Bankbuster777/Akwek/window_handle/images/back_socket.png

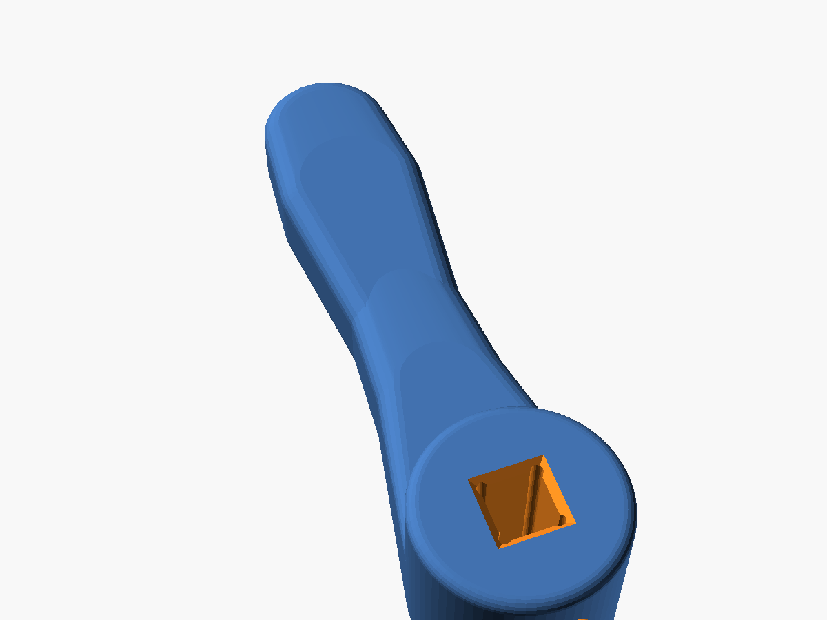
window_handle/images/back_socket.png
