Bankbuster777/Akwek/window_handle/images/screw_detail.png

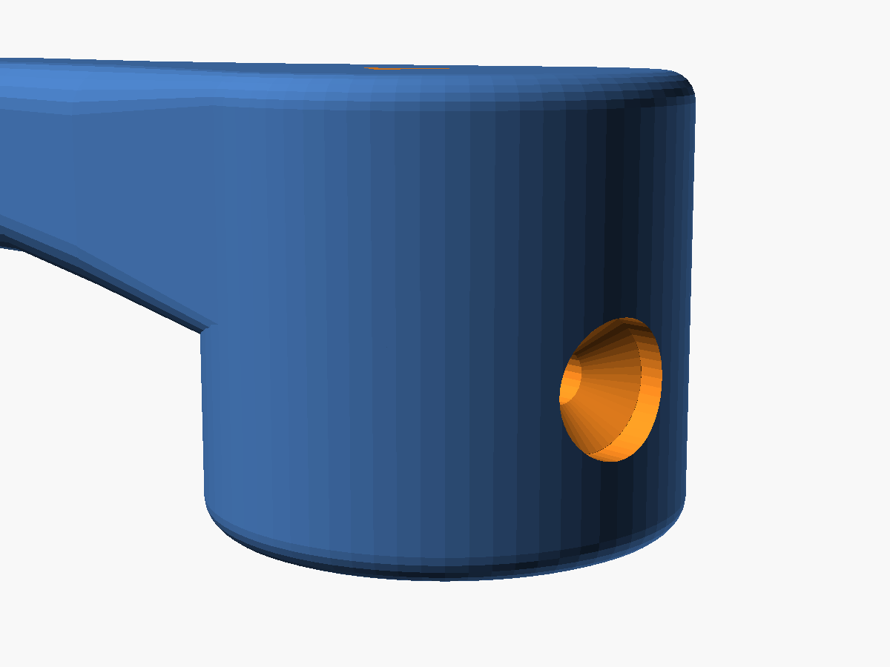
window_handle/images/screw_detail.png
