Bankbuster777/Akwek/window_handle/images/section.png

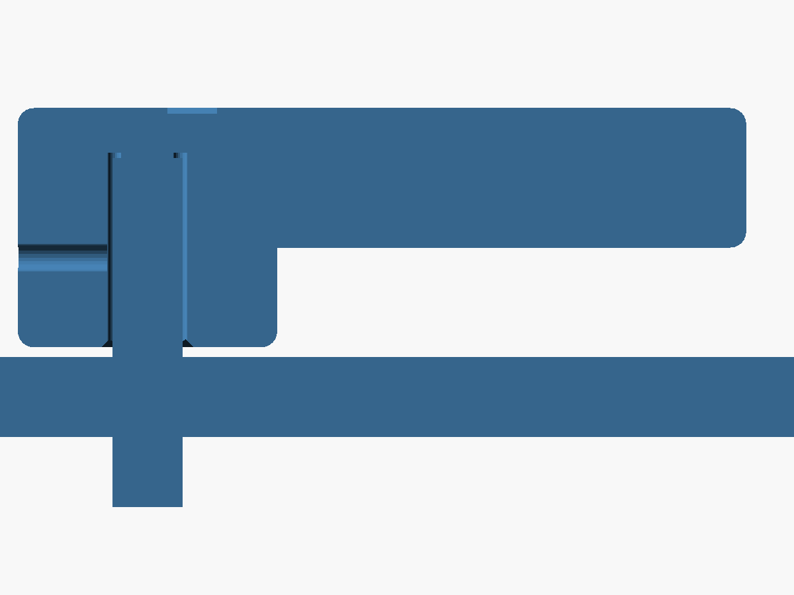
window_handle/images/section.png
