Bankbuster777/Akwek/window_handle/window_handle_7mm.stl

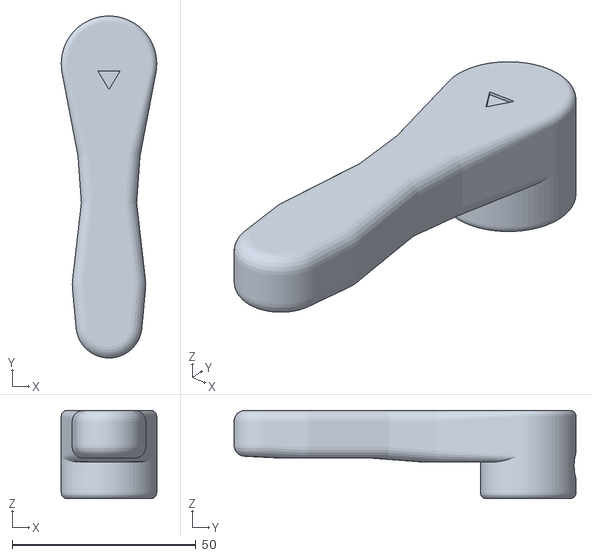
[picture p5: CAD file, 2026-11-01]
window_handle/window_handle_7mm.stl
26.0 x 93.0 x 24.0
