Bankbuster777/Akwek/window_handle/fit_test_coupon.stl

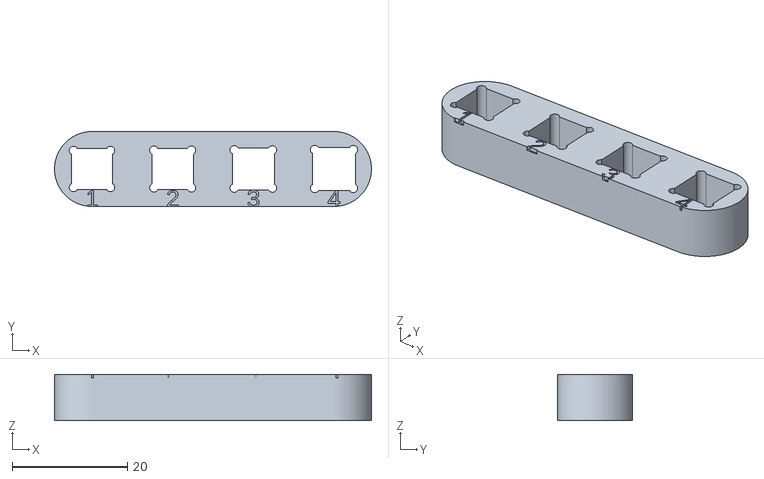
[picture p6: CAD file, 2026-10-31]
window_handle/fit_test_coupon.stl
55.0 x 13.0 x 8.00
