Bankbuster777/Akwek/window_handle/images/assembly.png

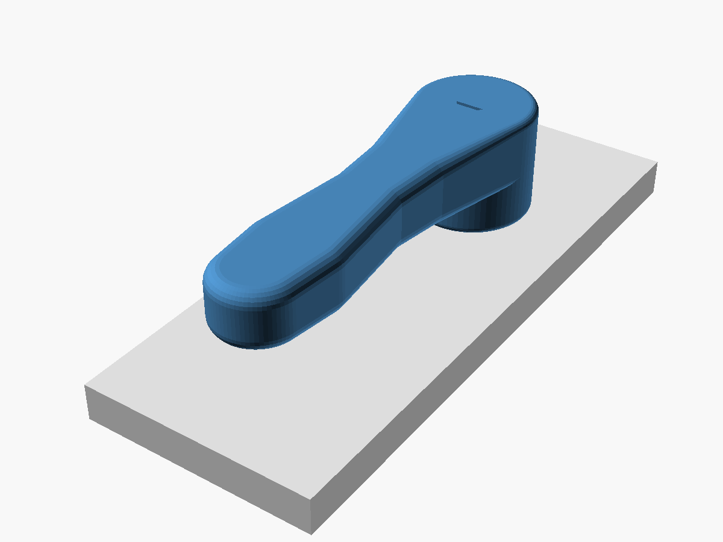
window_handle/images/assembly.png
