Bankbuster777/Akwek/window_handle/images/print_pose.png

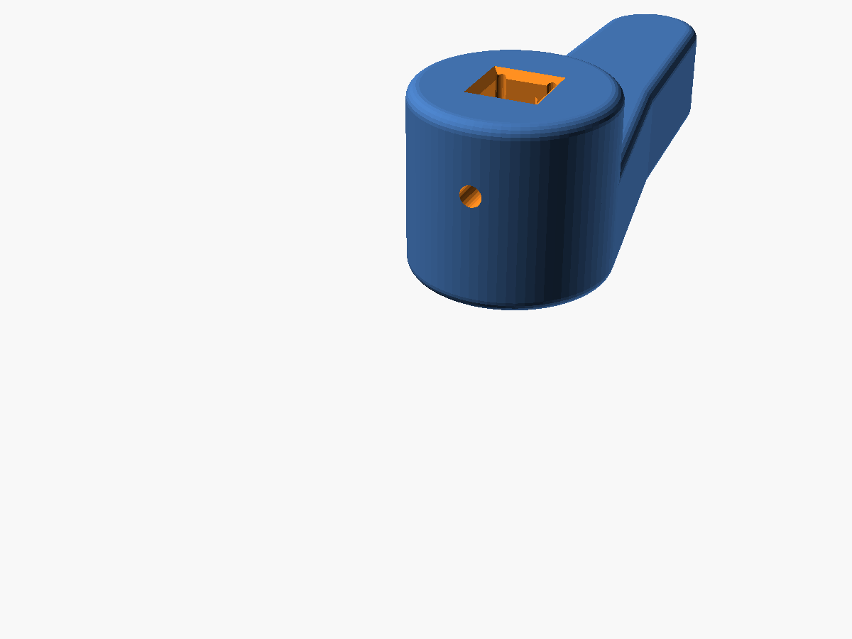
window_handle/images/print_pose.png
