Bankbuster777/Akwek/(commit log)

2026-10-31 Add compact 3D-printable window handle for 7mm square spindle
    OpenSCAD parametric model, STL files, fit-test coupon, renders and
    annotated design sheet.
    Claude-Session: https://claude.ai/code/session_01VHHWM6CgTYeyh6XiKMasSA
2026-11-01 Window handle: countersunk M3x8 screw seat, longer ergonomic 80mm grip
    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
